plugz/kp_artnet2dmx6/kp_btns/kp_btns.kicad_pcb

## KiCad design kp_btns/kp_btns.kicad_pcb (2026-04-26)

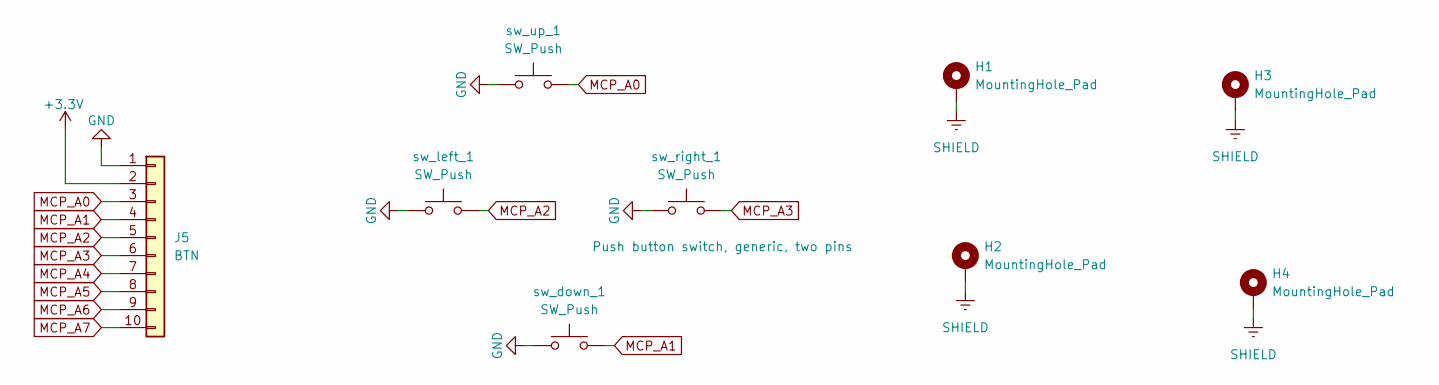
[picture p1: schematic kp_btns.kicad_sch]

Parts:
H1, H2, H3, H4: MountingHole_Pad; MountingHole_3.2mm_M3_Pad
J5: BTN; IDC-Header_2x05_P2.54mm_Vertical; JLCPCB Part # C5665
sw_down_1: SW_Push; SW_SPST_Omron_B3F-40xx
sw_left_1: SW_Push; SW_SPST_Omron_B3F-40xx
sw_right_1: SW_Push; SW_SPST_Omron_B3F-40xx
sw_up_1: SW_Push; SW_SPST_Omron_B3F-40xx

Connections:
+3.3V: J5.2
GND: J5.1, sw_down_1.1, sw_left_1.1, sw_right_1.1, sw_up_1.1
MCP_A0: J5.3, sw_up_1.2
MCP_A1: J5.4, sw_down_1.2
MCP_A2: J5.5, sw_left_1.2
MCP_A3: J5.6, sw_right_1.2
MCP_A4: J5.7
MCP_A5: J5.8
MCP_A6: J5.9
MCP_A7: J5.10
SHIELD: H1.1 (1_1), H2.1 (1_1), H3.1 (1_1), H4.1 (1_1)

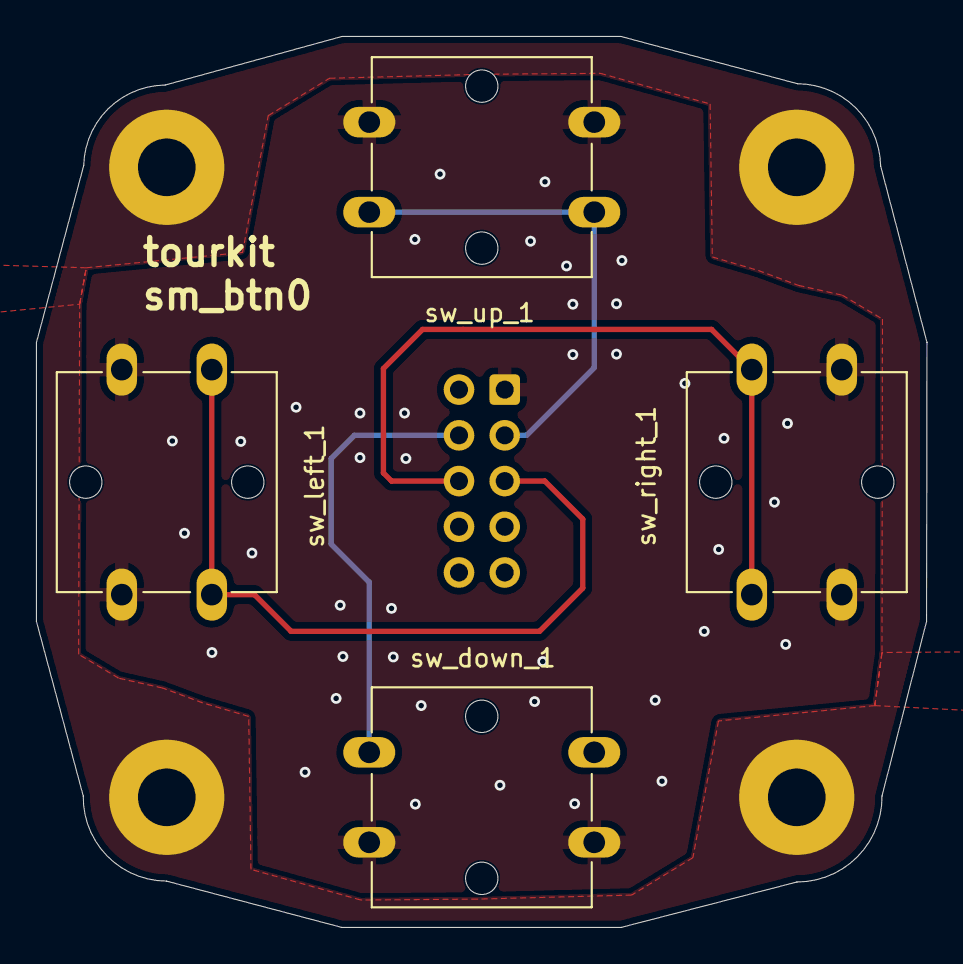
[picture p2: board kp_btns.kicad_pcb from above]

Board: 2 copper layers, 49.5 x 49.5 mm, 9 parts (1 on the bottom side), 6 nets.
