plugz/kp_artnet2dmx6/kp_dmxinout/kp_dmxinout.kicad_pcb

## KiCad design kp_dmxinout/kp_dmxinout.kicad_pcb (2026-04-26)

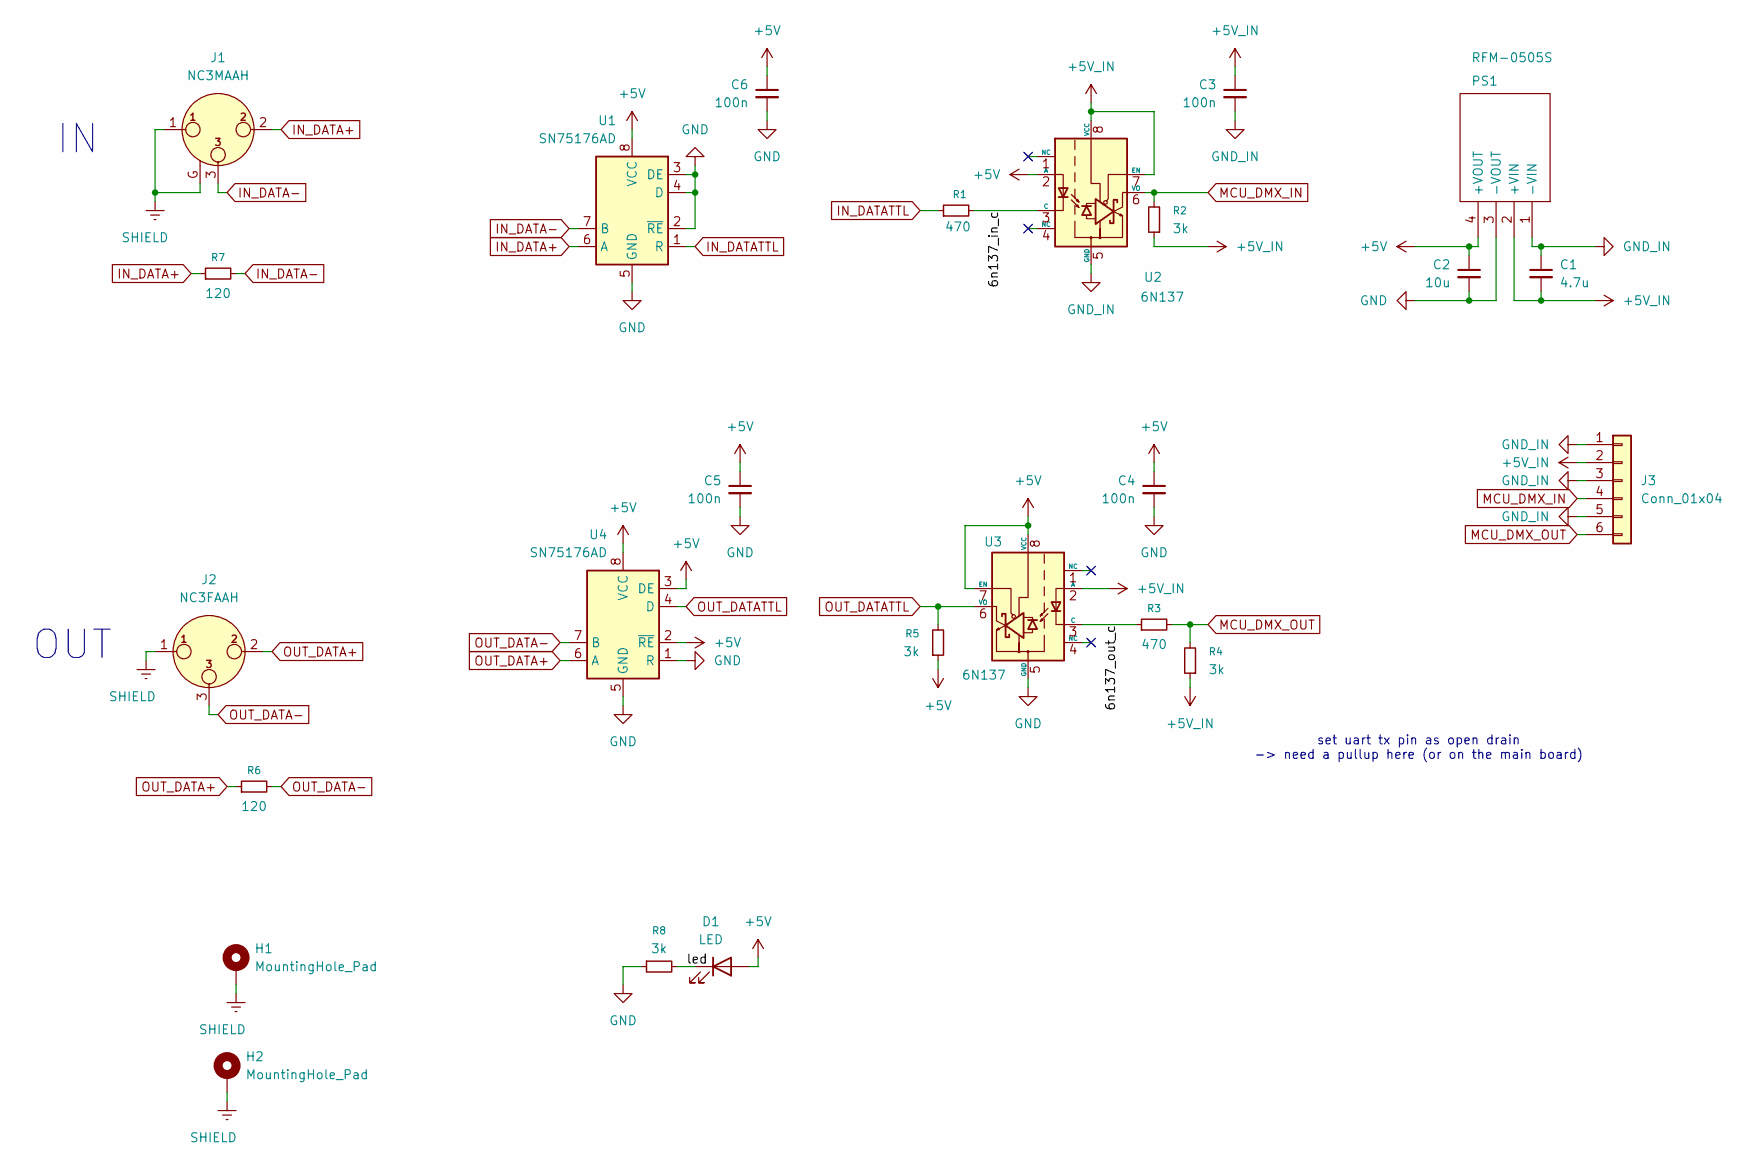
[picture p3: schematic kp_dmxinout.kicad_sch]

Parts:
C1: 4.7u; C_1206_3216Metric; LCSC C51205
C2: 10u; C_1206_3216Metric; LCSC C13585
C3, C4, C5, C6: 100n; C_0402_1005Metric; LCSC C1525
D1: LED; LED_0805_2012Metric; LCSC C965812
H1, H2: MountingHole_Pad; MountingHole_3.2mm_M3_Pad_Via
J1: NC3MAAH; Jack_XLR_Neutrik_NC3MAAH_Horizontal; LCSC C368463
J2: NC3FAAH; Jack_XLR_Neutrik_NC3FAAH_Horizontal; LCSC C368521
J3: Conn_01x04; IDC-Header_2x03_P2.54mm_Vertical; LCSC C11214
PS1: RFM-0505S; RFM0505S; Manufacturer_Part_Number RFM-0505S; LCSC C22371855
R1, R3: 470; R_0603_1608Metric; LCSC C844786
R2, R4, R5, R8: 3k; R_0805_2012Metric; LCSC C126350
R6, R7: 120; R_0603_1608Metric; LCSC C844736
U1, U4: SN75176AD; SOIC-8_3.9x4.9mm_P1.27mm; LCSC C468242
U2, U3: 6N137; DIP-8_W7.62mm; LCSC C142297

Connections:
+5V: C2.1, C4.1, C5.1, C6.1, D1.2 (A), PS1.4 (+VOUT), R5.1, U1.8 (VCC), U2.2 (A), U3.7 (EN), U3.8 (VCC), U4.2 (~RE), U4.3 (DE), U4.8 (VCC)
+5V_IN: C1.2, C3.1, J3.2, PS1.2 (+VIN), R2.1, R4.1, U2.7 (EN), U2.8 (VCC), U3.2 (A)
/6n137_in_c: R1.2, U2.3 (C)
/6n137_out_c: R3.1, U3.3 (C)
/led: D1.1 (K), R8.2
GND: C2.2, C4.2, C5.2, C6.2, PS1.3 (-VOUT), R8.1, U1.2 (~RE), U1.3 (DE), U1.4 (D), U1.5 (GND), U3.5 (GND), U4.1 (R), U4.5 (GND)
GND_IN: C1.1, C3.2, J3.1, J3.3, J3.5, PS1.1 (-VIN), U2.5 (GND)
IN_DATA+: J1.2, R7.1, U1.6 (A)
IN_DATA-: J1.3, R7.2, U1.7 (B)
IN_DATATTL: R1.1, U1.1 (R)
MCU_DMX_IN: J3.4, R2.2, U2.6 (VO)
MCU_DMX_OUT: J3.6, R3.2, R4.2
OUT_DATA+: J2.2, R6.1, U4.6 (A)
OUT_DATA-: J2.3, R6.2, U4.7 (B)
OUT_DATATTL: R5.2, U3.6 (VO), U4.4 (D)
SHIELD: H1.1 (1_1), H2.1 (1_1), J1.1, J1.G, J2.1

Notes on the sheet:
set uart tx pin as open drain -> need a pullup here (or on the main board)
OUT

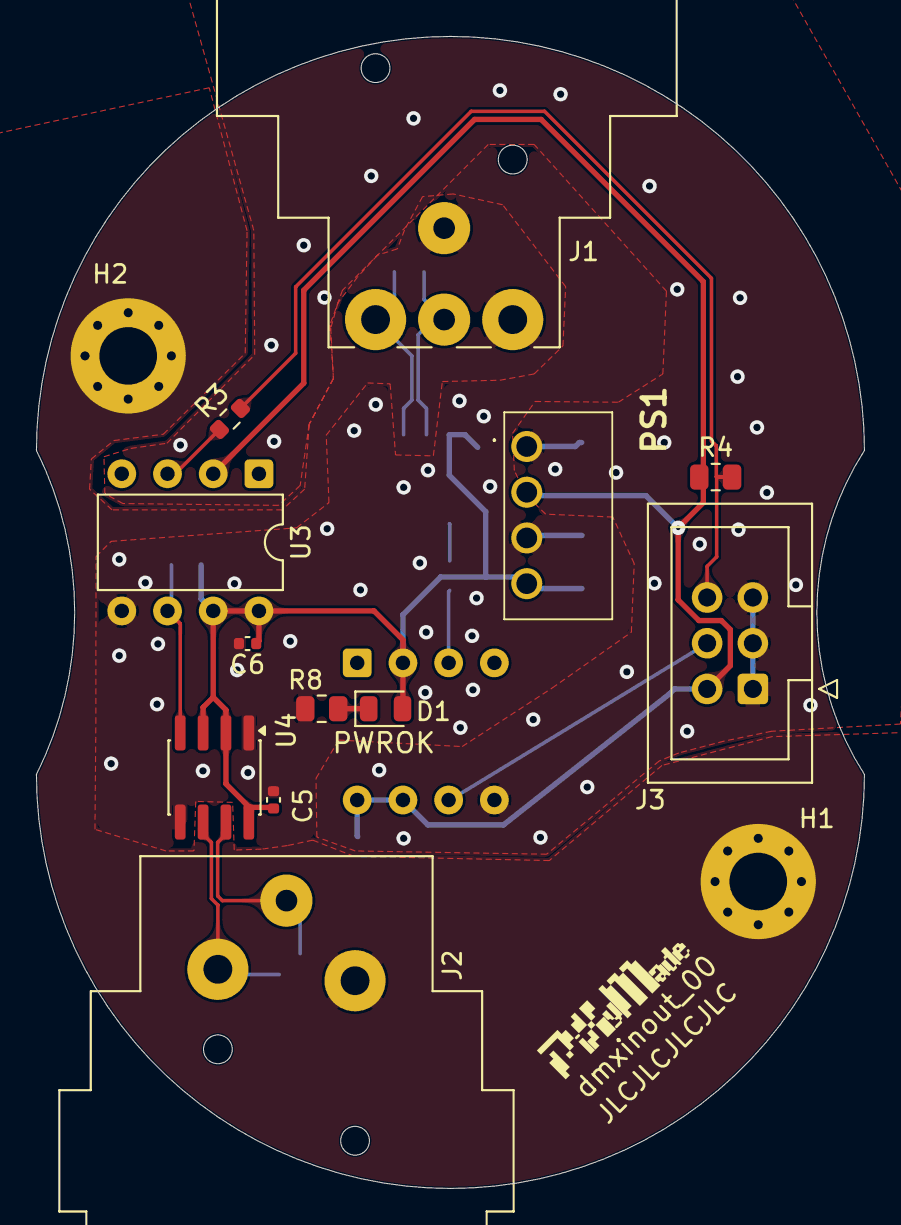
[picture p4: board kp_dmxinout.kicad_pcb from above]

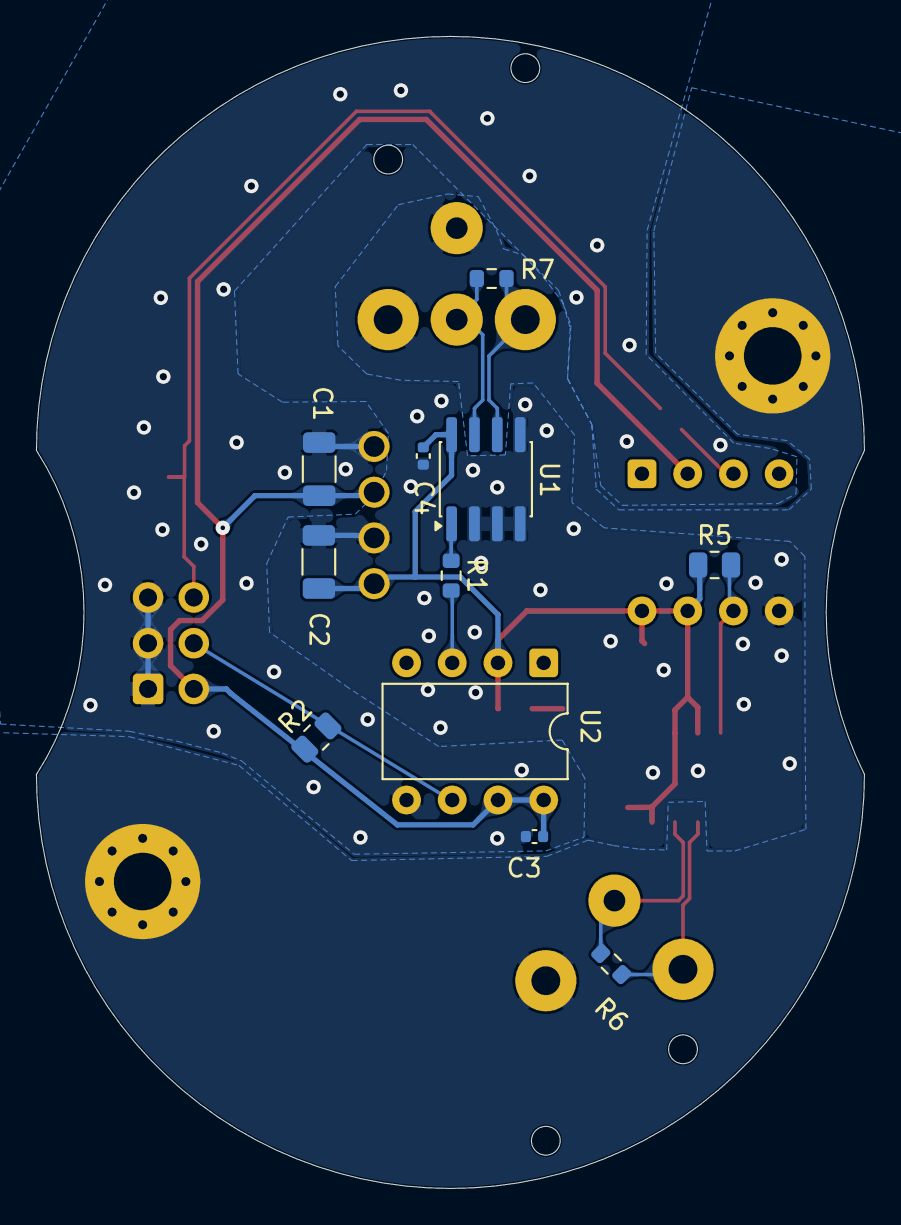
[picture p5: board kp_dmxinout.kicad_pcb from below]

Board: 2 copper layers, 46.0 x 64.0 mm, 25 parts (11 on the bottom side), 16 nets.
