plugz/kp_artnet2dmx6/kp_artnet2dmx6.kicad_pcb

## KiCad design kp_artnet2dmx6.kicad_pcb (2026-04-25)

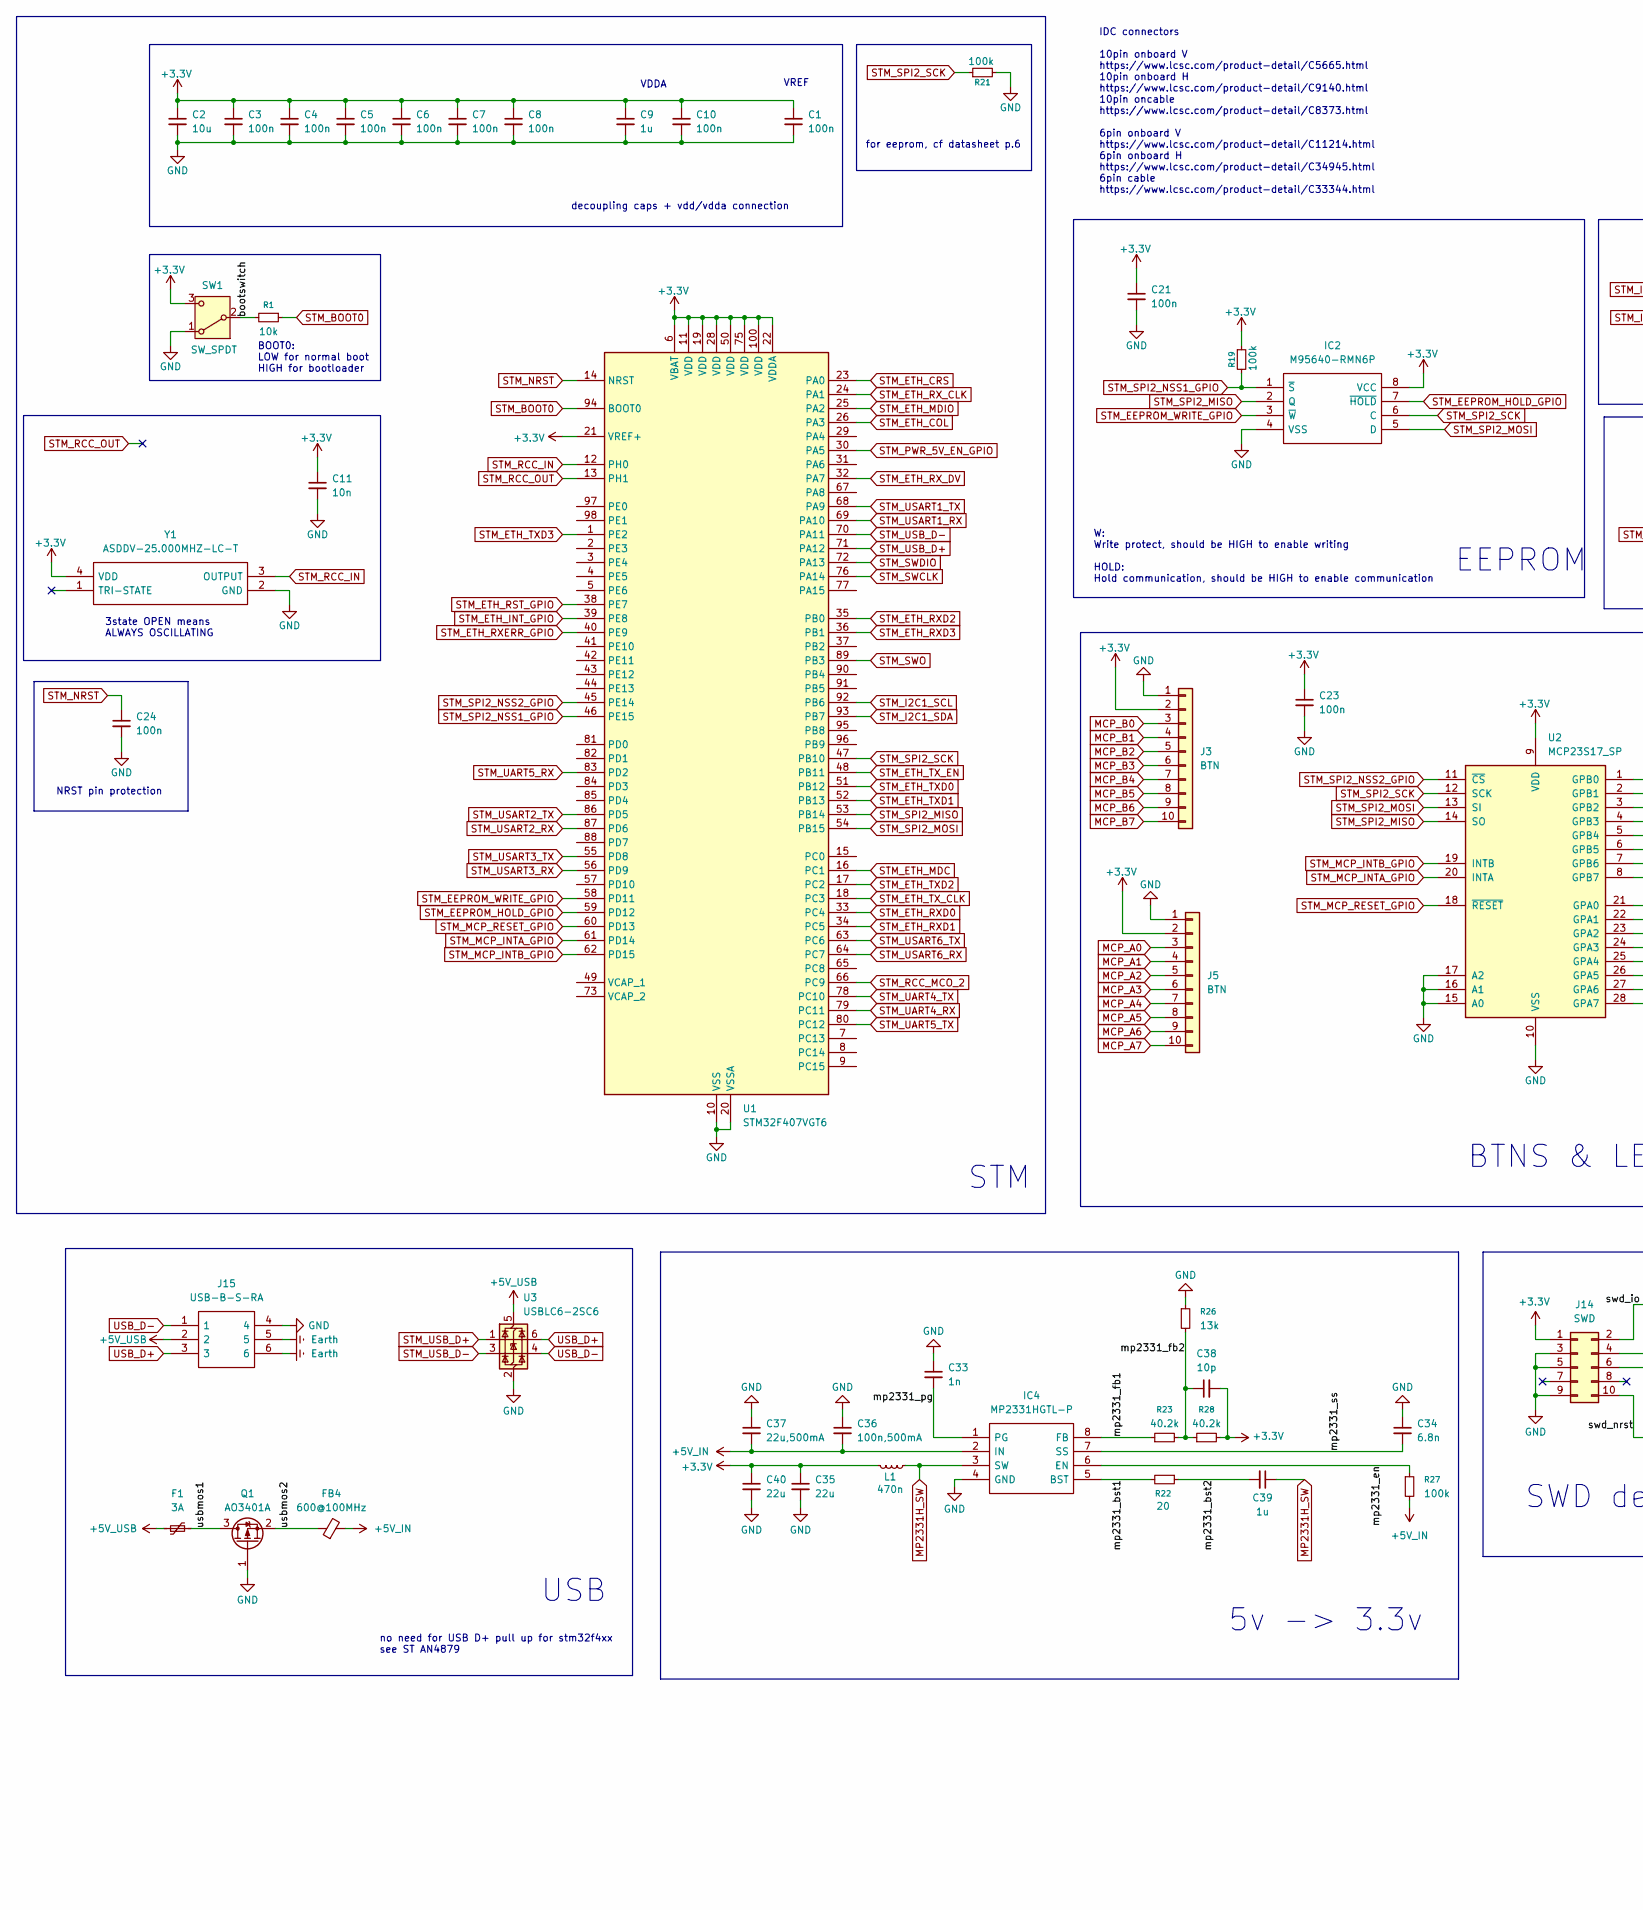
[picture p6: schematic kp_artnet2dmx6.kicad_sch, part in row 1, column 1]

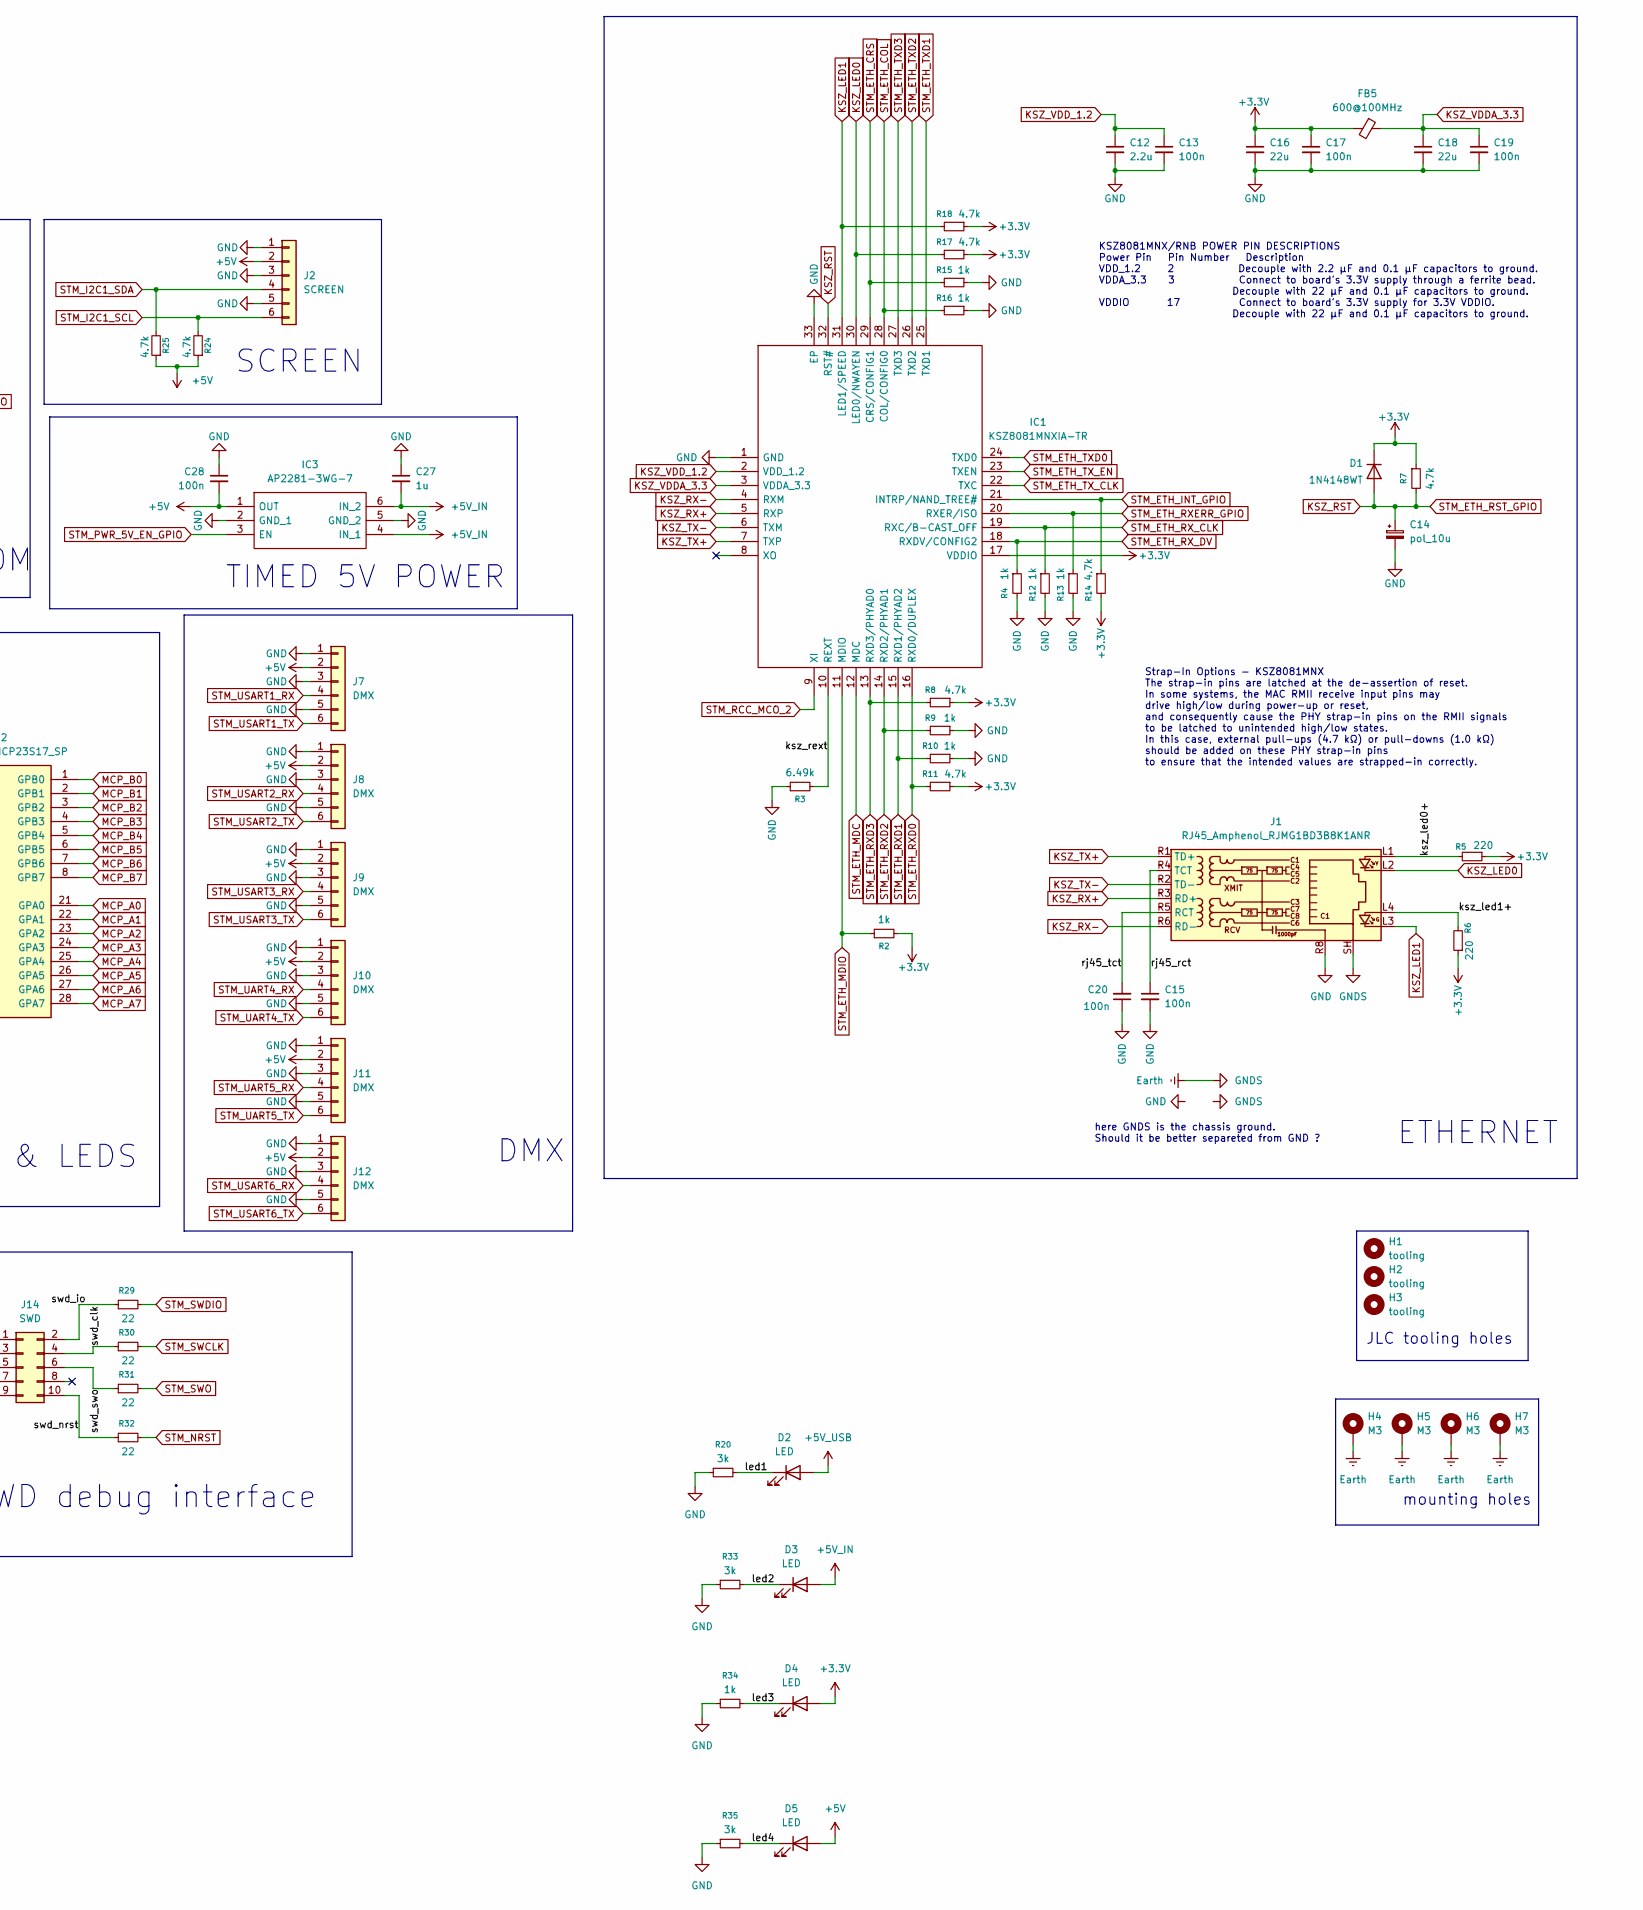
[picture p7: schematic kp_artnet2dmx6.kicad_sch, part in row 1, column 2]

Parts:
C1, C3, C4, C5, C6, C7, C8, C10, C13, C15, C17, C19, C20, C21, C23, C24, C28: 100n; C_0402_1005Metric; JLCPCB Part # C1525
C2: 10u; C_1206_3216Metric; JLCPCB Part # C9807
C9, C27, C39: 1u; C_0805_2012Metric; JLCPCB Part # C24123
C11: 10n; C_0402_1005Metric; JLCPCB Part # C15195
C12: 2.2u; C_0805_2012Metric; JLCPCB Part # C19110
C14: pol_10u; C_0603_1608Metric; JLCPCB Part # C2158420
C16, C18, C35, C40: 22u; C_1206_3216Metric; JLCPCB Part # C5177178
C33: 1n; C_0402_1005Metric; JLCPCB Part # C14442
C34: 6.8n; C_0402_1005Metric; JLCPCB Part # C161171
C36: 100n,500mA; C_0402_1005Metric; JLCPCB Part # C1525
C37: 22u,500mA; C_1206_3216Metric; JLCPCB Part # C5177178
C38: 10p; C_0402_1005Metric; JLCPCB Part # C32949
D1: 1N4148WT; D_SOD-523; JLCPCB Part # C232841
D2, D3, D4, D5: LED; LED_0805_2012Metric
F1: 3A; Fuse_1812_4532Metric; JLCPCB Part # C18198349
FB4, FB5: 600@100MHz; L_1206_3216Metric; JLCPCB Part # C2858472
H1, H2, H3: tooling; ToolingHole_1.152mm
H4, H5, H6, H7: M3; MountingHole_3.2mm_M3_Pad_Via
IC1: KSZ8081MNXIA-TR; QFN50P500X500X100-33N-D; Mouser Part Number 998-KSZ8081MNXIATR
IC2: M95640-RMN6P; SOIC127P600X175-8N; Manufacturer_Part_Number M95640-RMN6P
IC3: AP2281-3WG-7; SOT95P285X140-6N; Manufacturer_Part_Number AP2281-3WG-7; JLCPCB Part # C128634
IC4: MP2331HGTL-P; MP2331HGTLP; Manufacturer_Part_Number MP2331HGTL-P; Mouser Part Number 946-MP2331HGTL-P
J1: RJ45_Amphenol_RJMG1BD3B8K1ANR
J2: SCREEN; IDC-Header_2x03_P2.54mm_Vertical
J3, J5: BTN; IDC-Header_2x05_P2.54mm_Vertical
J7, J8, J9, J10, J11, J12: DMX; IDC-Header_2x03_P2.54mm_Vertical
J14: SWD; PinSocket_2x05_P1.27mm_Vertical_SMD
J15: USB-B-S-RA; USBBSRA; Manufacturer_Part_Number USB-B-S-RA
L1: 470n; L_Bourns_SRP4020CC
Q1: AO3401A; SOT-23; JLCPCB Part # C15127
R1: 10k; R_0603_1608Metric; JLCPCB Part # C844918
R2, R4, R9, R10, R12, R13, R15, R16, R34: 1k; R_0603_1608Metric; JLCPCB Part # C844920
R3: 6.49k; R_0805_2012Metric; JLCPCB Part # C2933484
R5, R6: 220; R_0805_2012Metric; JLCPCB Part # C2933537
R7, R8, R11, R14, R17, R18, R24, R25: 4.7k; R_0603_1608Metric; JLCPCB Part # C23162
R19, R21, R27: 100k; R_0603_1608Metric; JLCPCB Part # C2907088
R20, R33, R35: 3k; R_0805_2012Metric
R22: 20; R_0805_2012Metric; JLCPCB Part # C17544
R23, R28: 40.2k; R_0805_2012Metric; JLCPCB Part # C17678
R26: 13k; R_0805_2012Metric; JLCPCB Part # C17455
R29, R30, R31, R32: 22; R_0805_2012Metric; JLCPCB Part # C17561
SW1: SW_SPDT; SW_SPDT_PCM12
U1: STM32F407VGT6; LQFP-100_14x14mm_P0.5mm; JLCPCB Part # C12345
U2: MCP23S17_SP; DIP-28_W7.62mm; farnell link already have
U3: USBLC6-2SC6; SOT-23-6; JLCPCB Part # C7519
Y1: ASDDV-25.000MHZ-LC-T; AbraconASDDV; Manufacturer_Part_Number ASDDV-25.000MHZ-LC-T; Mouser Part Number 815-ASDDV-2500MHZLCT

Connections:
+3.3V: C1.1, C2.1, C3.1, C4.1, C5.1, C6.1, C7.1, C8.1, C9.1, C10.1, C11.1, C16.1, C17.1, C21.1, C23.1, C35.1, C38.2, C40.1, D1.1 (K), D4.2 (A), FB5.2, IC1.17 (VDDIO), IC2.8 (VCC), J3.2, J5.2, J14.1, L1.2, R2.2, R5.1, R6.1, R7.1, R8.1, R11.1, R14.2, R17.1, R18.1, R19.1, R28.2, SW1.3 (C), U1.6 (VBAT), U1.11 (VDD), U1.19 (VDD), U1.21 (VREF+), U1.22 (VDDA), U1.28 (VDD), U1.50 (VDD), U1.75 (VDD), U1.100 (VDD), U2.9 (VDD), Y1.4 (VDD)
+5V: C28.2, D5.2 (A), IC3.1 (OUT), J2.2, J7.2, J8.2, J9.2, J10.2, J11.2, J12.2, R24.1, R25.1
+5V_IN: C27.2, C36.2, C37.2, D3.2 (A), FB4.2, IC3.4 (IN_1), IC3.6 (IN_2), IC4.2 (IN), R27.2
+5V_USB: D2.2 (A), F1.1, J15.2, U3.5 (VBUS)
/bootswitch: R1.2, SW1.2 (B)
/ksz_led0+: J1.L1, R5.2
/ksz_led1+: J1.L4, R6.2
/ksz_rext: IC1.10 (REXT), R3.2
/led1: D2.1 (K), R20.2
/led2: D3.1 (K), R33.2
/led3: D4.1 (K), R34.2
/led4: D5.1 (K), R35.2
/mp2331_bst1: IC4.5 (BST), R22.2
/mp2331_bst2: C39.2, R22.1
/mp2331_en: IC4.6 (EN), R27.1
/mp2331_fb1: IC4.8 (FB), R23.1
/mp2331_fb2: C38.1, R23.2, R26.2, R28.1
/mp2331_pg: C33.2, IC4.1 (PG)
/mp2331_ss: C34.2, IC4.7 (SS)
/rj45_rct: C15.1, J1.R4 (TCT)
/rj45_tct: C20.2, J1.R5 (RCT)
/swd_clk: J14.4, R30.1
/swd_io: J14.2, R29.1
/swd_nrst: J14.10, R32.1
/swd_swo: J14.6, R31.1
/usbmos1: F1.2, Q1.3 (D)
/usbmos2: FB4.1, Q1.2 (S)
Earth: H4.1 (1_1), H5.1 (1_1), H6.1 (1_1), H7.1 (1_1), J1.SH, J15.5, J15.6
GND: C1.2, C2.2, C3.2, C4.2, C5.2, C6.2, C7.2, C8.2, C9.2, C10.2, C11.2, C12.2, C13.2, C14.2, C15.2, C16.2, C17.2, C18.2, C19.2, C20.1, C21.2, C23.2, C24.2, C27.1, C28.1, C33.1, C34.1, C35.2, C36.1, C37.1, C40.2, IC1.1 (GND), IC1.33 (EP), IC2.4 (VSS), IC3.2 (GND_1), IC3.5 (GND_2), IC4.4 (GND), J1.R8, J2.1, J2.3, J2.5, J3.1, J5.1, J7.1, J7.3, J7.5, J8.1, J8.3, J8.5, J9.1, J9.3, J9.5, J10.1, J10.3, J10.5, J11.1, J11.3, J11.5, J12.1, J12.3, J12.5, J14.3, J14.5, J14.9, J15.4, Q1.1 (G), R3.1, R4.2, R9.1, R10.1, R12.2, R13.2, R15.1, R16.1, R20.1, R21.2, R26.1, R33.1, R34.1, R35.1, SW1.1 (A), U1.10 (VSS), U1.20 (VSSA), U1.27 (VSS), U1.74 (VSS), U1.99 (VSS), U2.10 (VSS), U2.15 (A0), U2.16 (A1), U2.17 (A2), U3.2 (GND), Y1.2 (GND)
KSZ_LED0: IC1.30 (LED0/NWAYEN), J1.L2, R17.2
KSZ_LED1: IC1.31 (LED1/SPEED), J1.L3, R18.2
KSZ_RST: C14.1, D1.2 (A), IC1.32 (RST#), R7.2, U1.38 (PE7)
KSZ_RX+: IC1.5 (RXP), J1.R3 (RD+)
KSZ_RX-: IC1.4 (RXM), J1.R6 (RD-)
KSZ_TX+: IC1.7 (TXP), J1.R1 (TD+)
KSZ_TX-: IC1.6 (TXM), J1.R2 (TD-)
KSZ_VDDA_3.3: C18.1, C19.1, FB5.1, IC1.3 (VDDA_3.3)
KSZ_VDD_1.2: C12.1, C13.1, IC1.2 (VDD_1.2)
MCP_A0: J5.3, U2.21 (GPA0)
MCP_A1: J5.4, U2.22 (GPA1)
MCP_A2: J5.5, U2.23 (GPA2)
MCP_A3: J5.6, U2.24 (GPA3)
MCP_A4: J5.7, U2.25 (GPA4)
MCP_A5: J5.8, U2.26 (GPA5)
MCP_A6: J5.9, U2.27 (GPA6)
MCP_A7: J5.10, U2.28 (GPA7)
MCP_B0: J3.3, U2.1 (GPB0)
MCP_B1: J3.4, U2.2 (GPB1)
MCP_B2: J3.5, U2.3 (GPB2)
MCP_B3: J3.6, U2.4 (GPB3)
MCP_B4: J3.7, U2.5 (GPB4)
MCP_B5: J3.8, U2.6 (GPB5)
MCP_B6: J3.9, U2.7 (GPB6)
MCP_B7: J3.10, U2.8 (GPB7)
MP2331H_SW: C39.1, IC4.3 (SW), L1.1
STM_BOOT0: R1.1, U1.94 (BOOT0)
STM_EEPROM_HOLD_GPIO: IC2.7 (~HOLD), U1.59 (PD12)
STM_EEPROM_WRITE_GPIO: IC2.3 (~W), U1.58 (PD11)
STM_ETH_COL: IC1.28 (COL/CONFIG0), R16.2, U1.26 (PA3)
STM_ETH_CRS: IC1.29 (CRS/CONFIG1), R15.2, U1.23 (PA0)
STM_ETH_INT_GPIO: IC1.21 (INTRP/NAND_TREE#), R14.1, U1.39 (PE8)
STM_ETH_MDC: IC1.12 (MDC), U1.16 (PC1)
STM_ETH_MDIO: IC1.11 (MDIO), R2.1, U1.25 (PA2)
STM_ETH_RXD0: IC1.16 (RXD0/DUPLEX), R11.2, U1.33 (PC4)
STM_ETH_RXD1: IC1.15 (RXD1/PHYAD2), R10.2, U1.34 (PC5)
STM_ETH_RXD2: IC1.14 (RXD2/PHYAD1), R9.2, U1.35 (PB0)
STM_ETH_RXD3: IC1.13 (RXD3/PHYAD0), R8.2, U1.36 (PB1)
STM_ETH_RXERR_GPIO: IC1.20 (RXER/ISO), R13.1, U1.40 (PE9)
STM_ETH_RX_CLK: IC1.19 (RXC/B-CAST_OFF), R12.1, U1.24 (PA1)
STM_ETH_RX_DV: IC1.18 (RXDV/CONFIG2), R4.1, U1.32 (PA7)
STM_ETH_TXD0: IC1.24 (TXD0), U1.51 (PB12)
STM_ETH_TXD1: IC1.25 (TXD1), U1.52 (PB13)
STM_ETH_TXD2: IC1.26 (TXD2), U1.17 (PC2)
STM_ETH_TXD3: IC1.27 (TXD3), U1.1 (PE2)
STM_ETH_TX_CLK: IC1.22 (TXC), U1.18 (PC3)
STM_ETH_TX_EN: IC1.23 (TXEN), U1.48 (PB11)
STM_I2C1_SCL: J2.6, R24.2, U1.92 (PB6)
STM_I2C1_SDA: J2.4, R25.2, U1.93 (PB7)
STM_MCP_INTA_GPIO: U1.61 (PD14), U2.20 (INTA)
STM_MCP_INTB_GPIO: U1.62 (PD15), U2.19 (INTB)
STM_MCP_RESET_GPIO: U1.60 (PD13), U2.18 (~RESET)
STM_NRST: C24.1, R32.2, U1.14 (NRST)
STM_PWR_5V_EN_GPIO: IC3.3 (EN), U1.30 (PA5)
STM_RCC_IN: U1.12 (PH0), Y1.3 (OUTPUT)
STM_RCC_MCO_2: IC1.9 (XI), U1.66 (PC9)
STM_RCC_OUT: U1.13 (PH1)
STM_SPI2_MISO: IC2.2 (Q), U1.53 (PB14), U2.14 (SO)
STM_SPI2_MOSI: IC2.5 (D), U1.54 (PB15), U2.13 (SI)
STM_SPI2_NSS1_GPIO: IC2.1 (~S), R19.2, U1.46 (PE15)
STM_SPI2_NSS2_GPIO: U1.45 (PE14), U2.11 (~CS)
STM_SPI2_SCK: IC2.6 (C), R21.1, U1.47 (PB10), U2.12 (SCK)
STM_SWCLK: R30.2, U1.76 (PA14)
STM_SWDIO: R29.2, U1.72 (PA13)
STM_SWO: R31.2, U1.89 (PB3)
STM_UART4_RX: J10.4, U1.79 (PC11)
STM_UART4_TX: J10.6, U1.78 (PC10)
STM_UART5_RX: J11.4, U1.83 (PD2)
STM_UART5_TX: J11.6, U1.80 (PC12)
STM_USART1_RX: J7.4, U1.69 (PA10)
STM_USART1_TX: J7.6, U1.68 (PA9)
STM_USART2_RX: J8.4, U1.87 (PD6)
STM_USART2_TX: J8.6, U1.86 (PD5)
STM_USART3_RX: J9.4, U1.56 (PD9)
STM_USART3_TX: J9.6, U1.55 (PD8)
STM_USART6_RX: J12.4, U1.64 (PC7)
STM_USART6_TX: J12.6, U1.63 (PC6)
STM_USB_D+: U1.71 (PA12), U3.1 (I/O1)
STM_USB_D-: U1.70 (PA11), U3.3 (I/O2)
USB_D+: J15.3, U3.6 (I/O1)
USB_D-: J15.1, U3.4 (I/O2)

Notes on the sheet:
DMX
SWD debug interface
5v -> 3.3v
KSZ8081MNX/RNB POWER PIN DESCRIPTIONS Power Pin Pin Number Description VDD_1.2 2 Decouple with 2.2 μF and 0.1 μF capacitors to ground. VDDA_3.3 3 Connect to board's 3.3V supply through a ferrite bead. Decouple with 22 μF and 0.1 μF capacitors to ground. VDDIO 17 Connect to board's 3.3V supply for 3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
BTNS & LEDS
here GNDS is the chassis ground. Should it be better separeted from GND ?
SCREEN
EEPROM
USB
for eeprom, cf datasheet p.6
W: Write protect, should be HIGH to enable writing HOLD: Hold communication, should be HIGH to enable communication
VDDA
JLC tooling holes
IDC connectors 10pin onboard V https://www.lcsc.com/product-detail/C5665.html 10pin onboard H https://www.lcsc.com/product-detail/C9140.html 10pin oncable https://www.lcsc.com/product-detail/C8373.html 6pin onboard V https://www.lcsc.com/product-detail/C11214.html 6pin onboard H https://www.lcsc.co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
VREF
TIMED 5V POWER
STM
decoupling caps + vdd/vdda connection
3state OPEN means ALWAYS OSCILLATING
ETHERNET
BOOT0: LOW for normal boot HIGH for bootloader
NRST pin protection
Strap-In Options - KSZ8081MNX The strap-in pins are latched at the de-assertion of reset. In some systems, the MAC RMII receive input pins may drive high/low during power-up or reset, and consequently cause the PHY strap-in pins on the RMII signals to be latched to unintended high/low states. In th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
mounting holes
no need for USB D+ pull up for stm32f4xx see ST AN4879

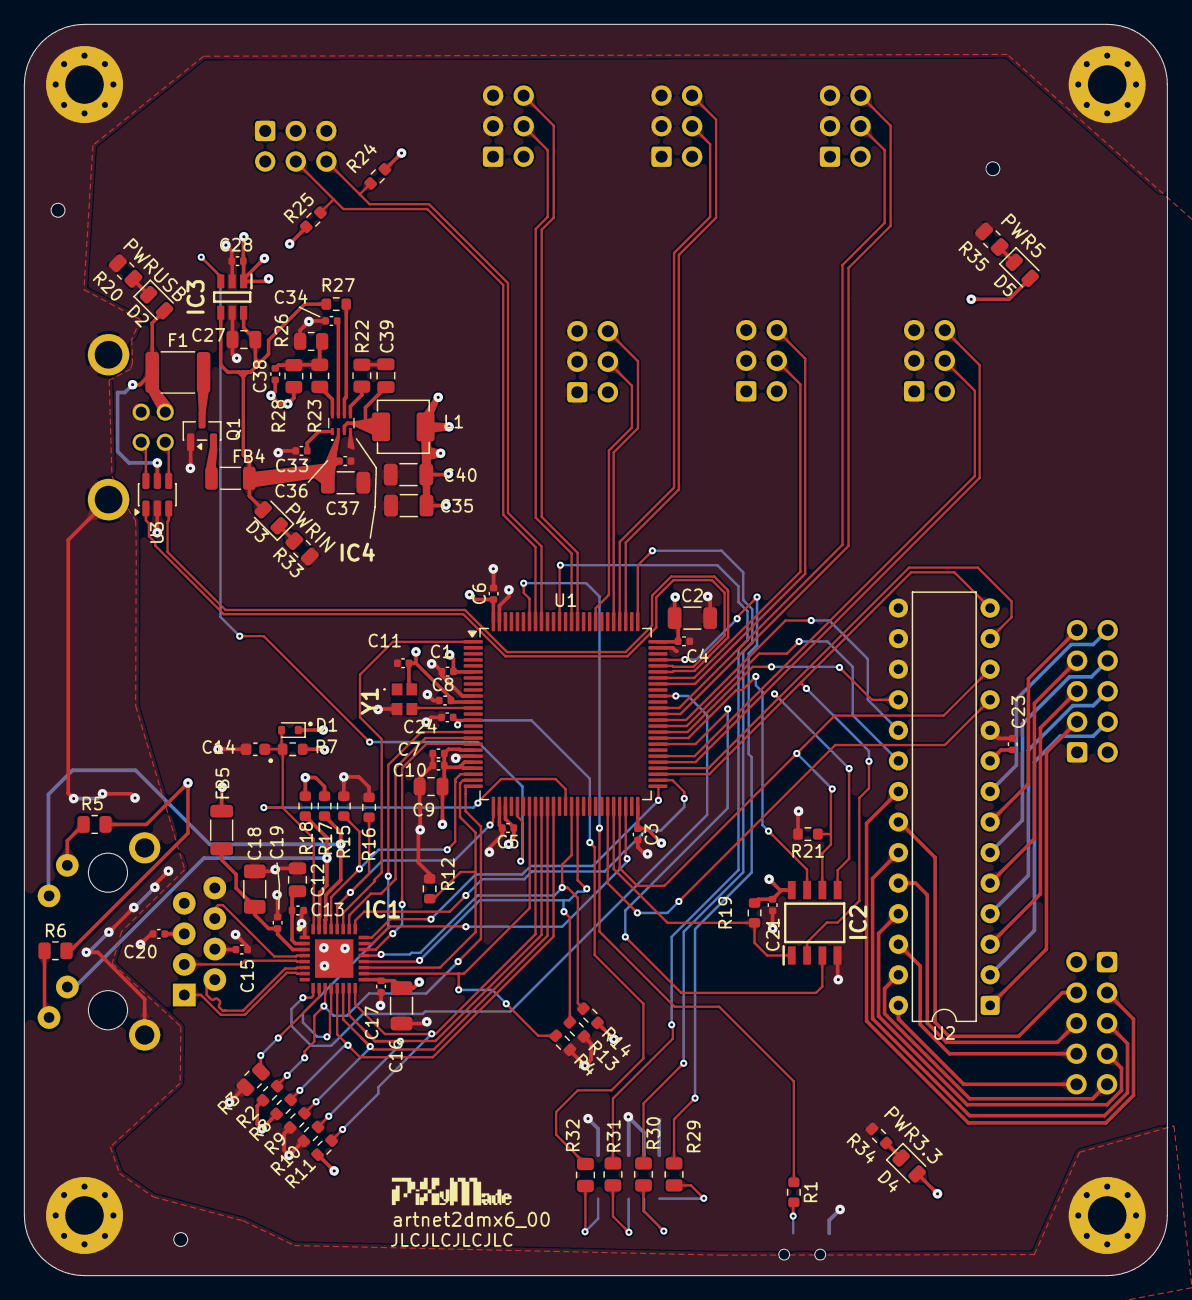
[picture p8: board kp_artnet2dmx6.kicad_pcb from above]

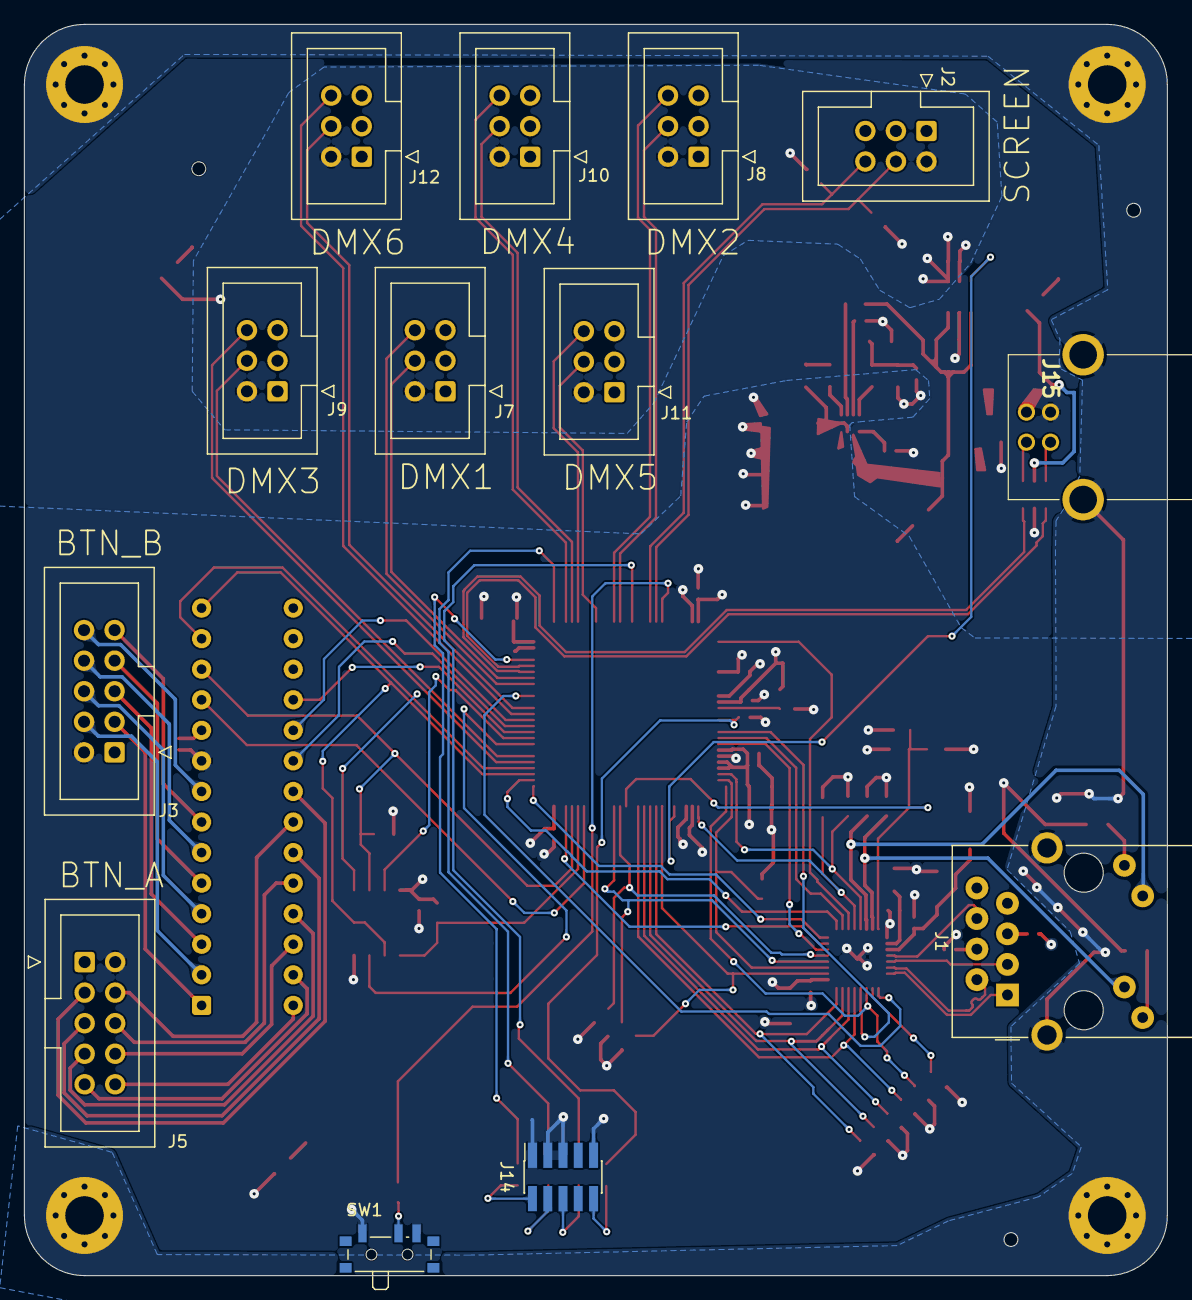
[picture p9: board kp_artnet2dmx6.kicad_pcb from below]

Board: 4 copper layers, 95.0 x 104.0 mm, 106 parts (13 on the bottom side), 109 nets.
