plugz/kp_artnet2dmx6/cubemx/artnet2dmx6_v0.ioc

Mcu.UserName=STM32F407VETx
PA0-WKUP.Signal=ETH_CRS
PA1.Signal=ETH_RX_CLK
PA10.Signal=USART1_RX
PA11.Signal=USB_OTG_FS_DM
PA12.Signal=USB_OTG_FS_DP
PA13.Signal=SYS_JTMS-SWDIO
PA14.Signal=SYS_JTCK-SWCLK
PA2.Signal=ETH_MDIO
PA3.Signal=ETH_COL
PA5.GPIO_Label=PWR_5V_EN_GPIO
PA5.Signal=GPIO_Output
PA7.Signal=ETH_RX_DV
PA9.Signal=USART1_TX
PB0.Signal=ETH_RXD2
PB1.Signal=ETH_RXD3
PB10.Signal=SPI2_SCK
PB11.Signal=ETH_TX_EN
PB12.Signal=ETH_TXD0
PB13.Signal=ETH_TXD1
PB14.Signal=SPI2_MISO
PB15.Signal=SPI2_MOSI
PB3.Signal=SYS_JTDO-SWO
PB6.Signal=I2C1_SCL
PB7.Signal=I2C1_SDA
PC1.Signal=ETH_MDC
PC10.Signal=UART4_TX
PC11.Signal=UART4_RX
PC12.Signal=UART5_TX
PC2.Signal=ETH_TXD2
PC3.Signal=ETH_TX_CLK
PC4.Signal=ETH_RXD0
PC5.Signal=ETH_RXD1
PC6.Signal=USART6_TX
PC7.Signal=USART6_RX
PC9.Signal=RCC_MCO_2
PD11.GPIO_Label=EEPROM_WRITE_GPIO
PD11.Signal=GPIO_Output
PD12.GPIO_Label=EEPROM_HOLD_GPIO
PD12.Signal=GPIO_Output
PD13.GPIO_Label=MCP_RESET_GPIO
PD13.Signal=GPIO_Output
PD14.GPIO_Label=MCP_INTA_GPIO
PD14.Signal=GPIO_Input
PD15.GPIO_Label=MCP_INTB_GPIO
PD15.Signal=GPIO_Input
PD2.Signal=UART5_RX
PD5.Signal=USART2_TX
PD6.Signal=USART2_RX
PD8.Signal=USART3_TX
PD9.Signal=USART3_RX
PE14.GPIO_Label=SPI2_NSS2_GPIO
PE14.Signal=GPIO_Output
PE15.GPIO_Label=SPI2_NSS1_GPIO
PE15.Signal=GPIO_Output
PE2.Signal=ETH_TXD3
PE7.GPIO_Label=ETH_RST_GPIO
PE7.Signal=GPIO_Output
PE8.GPIO_Label=ETH_INT_GPIO
PE8.Signal=GPIO_Input
PE9.GPIO_Label=ETH_RXERR_GPIO
PE9.Signal=GPIO_Input
PH0-OSC_IN.Signal=RCC_OSC_IN
PH1-OSC_OUT.Signal=RCC_OSC_OUT
