plugz/kp_artnet2dmx6/(commit log)

2026-02-15 add empty kicad project
    [kp_artnet2dmx6.kicad_pcb, kp_artnet2dmx6.kicad_sch]
2026-02-16 add stm32
    [kp_artnet2dmx6.kicad_sch]
2026-02-18 sch: add phy, add oscillator
    [kp_artnet2dmx6.kicad_sch]
2026-02-18 add ksz eth controller, todo finish connecting it
    [kp_artnet2dmx6.kicad_sch]
2026-02-20 connect ksz
    [kp_artnet2dmx6.kicad_sch]
2026-02-26 add eeprom
    [kp_artnet2dmx6.kicad_sch]
2026-02-26 connect eeprom
    [kp_artnet2dmx6.kicad_sch]
2026-02-27 add mcp
    [kp_artnet2dmx6.kicad_sch]
2026-02-27 add level shifter for i2c screen
    [kp_artnet2dmx6.kicad_sch]
2026-03-01 use delayed 5v supply, add dmxinout board
    [kp_artnet2dmx6.kicad_sch, kp_dmxinout.kicad_pcb, kp_dmxinout.kicad_sch]
2026-03-01 connect usb
    [kp_artnet2dmx6.kicad_sch]
2026-03-24 sch: swd debug interface
    [kp_artnet2dmx6.kicad_sch]
2026-03-24 footprints - the beginning
    [kp_artnet2dmx6.kicad_pcb, kp_artnet2dmx6.kicad_sch]
2026-03-25 all footprints assigned
    [kp_artnet2dmx6.kicad_pcb, kp_artnet2dmx6.kicad_sch]
2026-03-25 fix usb conn
    [kp_artnet2dmx6.kicad_pcb, kp_artnet2dmx6.kicad_sch]
2026-03-25 start placing pcb
    [kp_artnet2dmx6.kicad_pcb, kp_artnet2dmx6.kicad_sch]
2026-03-26 fill buy links
    [kp_artnet2dmx6.kicad_pcb, kp_artnet2dmx6.kicad_sch]
2026-03-26 cubemx: stm32f407VET -> stm32f407VGT
2026-04-13 update to kicad 10
    [kp_artnet2dmx6.kicad_pcb, kp_artnet2dmx6.kicad_sch, kp_dmxinout.kicad_pcb, kp_dmxinout.kicad_sch]
2026-04-16 start assigning netclasses
    [kp_artnet2dmx6.kicad_pcb, kp_artnet2dmx6.kicad_sch]
2026-04-17 main pcb : everything is connected
    [kp_artnet2dmx6.kicad_pcb, kp_artnet2dmx6.kicad_sch]
2026-04-21 fix drc errors
    [kp_artnet2dmx6.kicad_pcb, kp_artnet2dmx6.kicad_sch, kp_dmxinout.kicad_pcb]
2026-04-21 schematic: change connectors from jst xh to IDC
    [kp_artnet2dmx6.kicad_pcb, kp_artnet2dmx6.kicad_sch]
2026-04-21 sch: remove caps on connectors
    [kp_artnet2dmx6.kicad_sch]
2026-04-21 pcb: change connectors to IDC
    [kp_artnet2dmx6.kicad_pcb]
2026-04-21 dmxinout: do board
    [kp_artnet2dmx6.kicad_pcb, kp_dmxinout.kicad_pcb, kp_dmxinout.kicad_sch]
2026-04-22 dmx: disconnect shield & gnd
    [kp_dmxinout.kicad_pcb, kp_dmxinout.kicad_sch]
2026-04-24 main board : start doing sig gnd gnd sigpow
    [kp_artnet2dmx6.kicad_pcb, kp_artnet2dmx6.kicad_sch, kp_dmxinout.kicad_pcb, kp_dmxinout.kicad_sch]
2026-04-25 DRC OK
    [kp_artnet2dmx6.kicad_pcb, kp_artnet2dmx6.kicad_sch, kp_dmxinout.kicad_pcb]
2026-04-25 add pwr leds
    [kp_artnet2dmx6.kicad_pcb, kp_artnet2dmx6.kicad_sch, kp_dmxinout.kicad_pcb, kp_dmxinout.kicad_sch]
2026-04-26 Revert "cubemx: stm32f407VET -> stm32f407VGT"
    This reverts commit 2003c71da7baa62a417fca543b3340f338673223.
    [artnet2dmx6_v0.ioc]
2026-04-26 ready 4 prod
    [kp_artnet2dmx6.kicad_sch, kp_dmxinout.kicad_pcb, kp_dmxinout.kicad_sch]
2026-04-26 add btn board
    [kp_btns.kicad_pcb, kp_btns.kicad_sch]
2026-04-26 fabrication order launched
    [kp_artnet2dmx6.kicad_sch]
2026-05-13 fix L1 footprint
    [kp_artnet2dmx6.kicad_sch]
2026-07-15 update cubemx: use phy dp83848 driver
2026-07-15 cubemx: enable timer5 for microseconds
2026-07-16 invert dmx out DATA+ & DATA-
    [kp_dmxinout.kicad_sch]
2026-07-16 cubemx: enable interrupts&dma for uarts
2026-07-16 cubemx: enable i2c&spi interrupts
